lw1414/punch-replica/punch-replica/3D/SMD-4_L4.6-W6.5-H3.7-LS10.2-P2.54.step

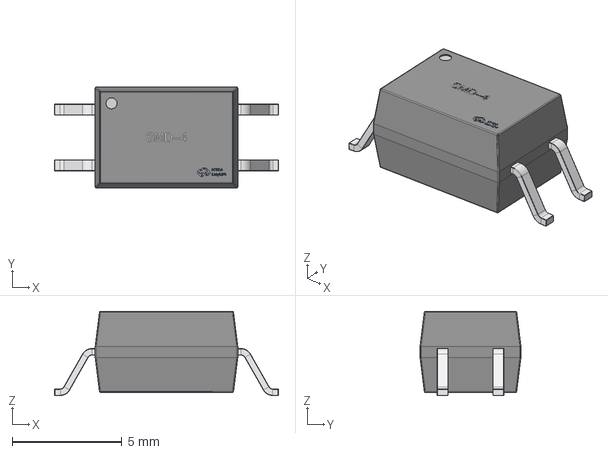
[picture p1: CAD file, 2026-02-18]
punch-replica/3D/SMD-4_L4.6-W6.5-H3.7-LS10.2-P2.54.step
10.2 x 4.60 x 3.85 mm
