lw1414/punch-replica/punch-replica/3D/SC-70-3_L2.0-W1.3-H1.0-P0.65.step

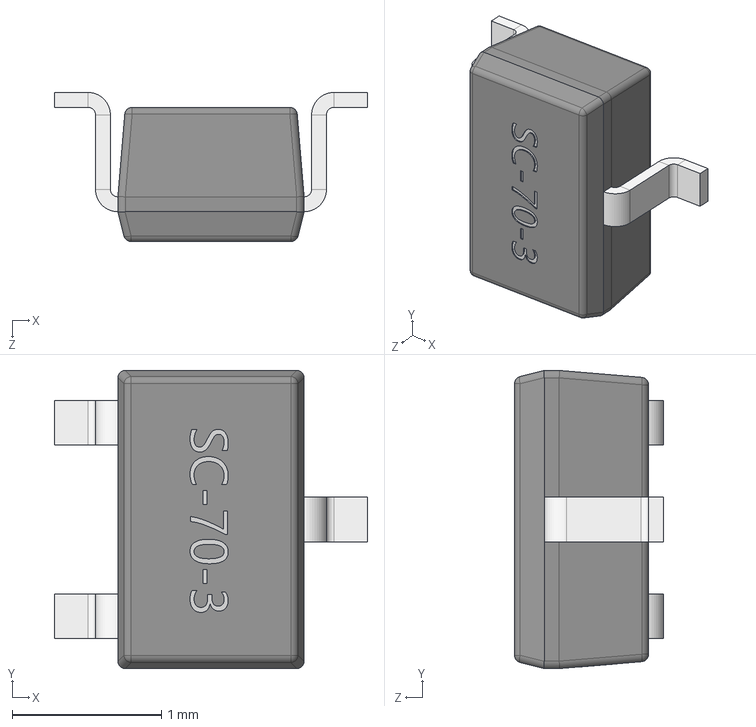
[picture p2: CAD file, 2026-02-18]
punch-replica/3D/SC-70-3_L2.0-W1.3-H1.0-P0.65.step
2.10 x 2.00 x 1.00 mm
