lw1414/punch-replica/punch-replica/3D/DFR0299.step

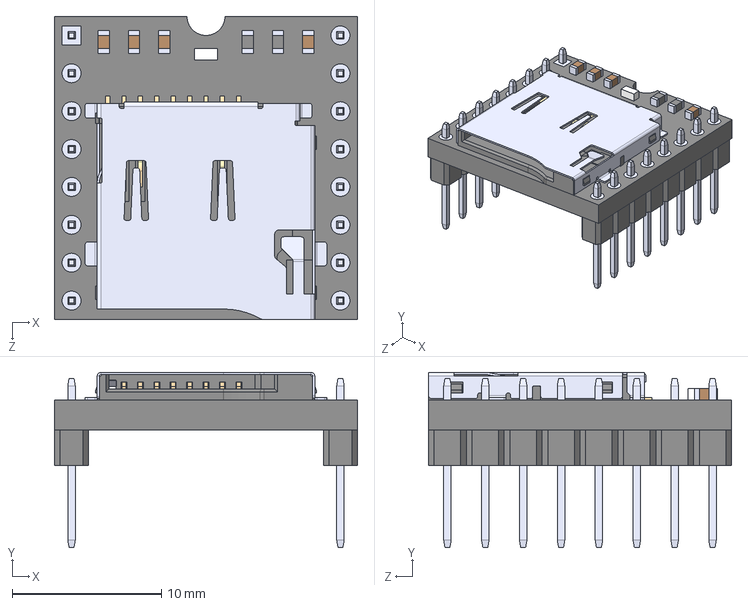
[picture p3: CAD file, 2026-02-18]
punch-replica/3D/DFR0299.step
20.3 x 11.8 x 20.3 mm
