lw1414/punch-replica/punch-replica/punch-replica.kicad_pcb

## KiCad design punch-replica/punch-replica.kicad_pcb (2026-03-03)

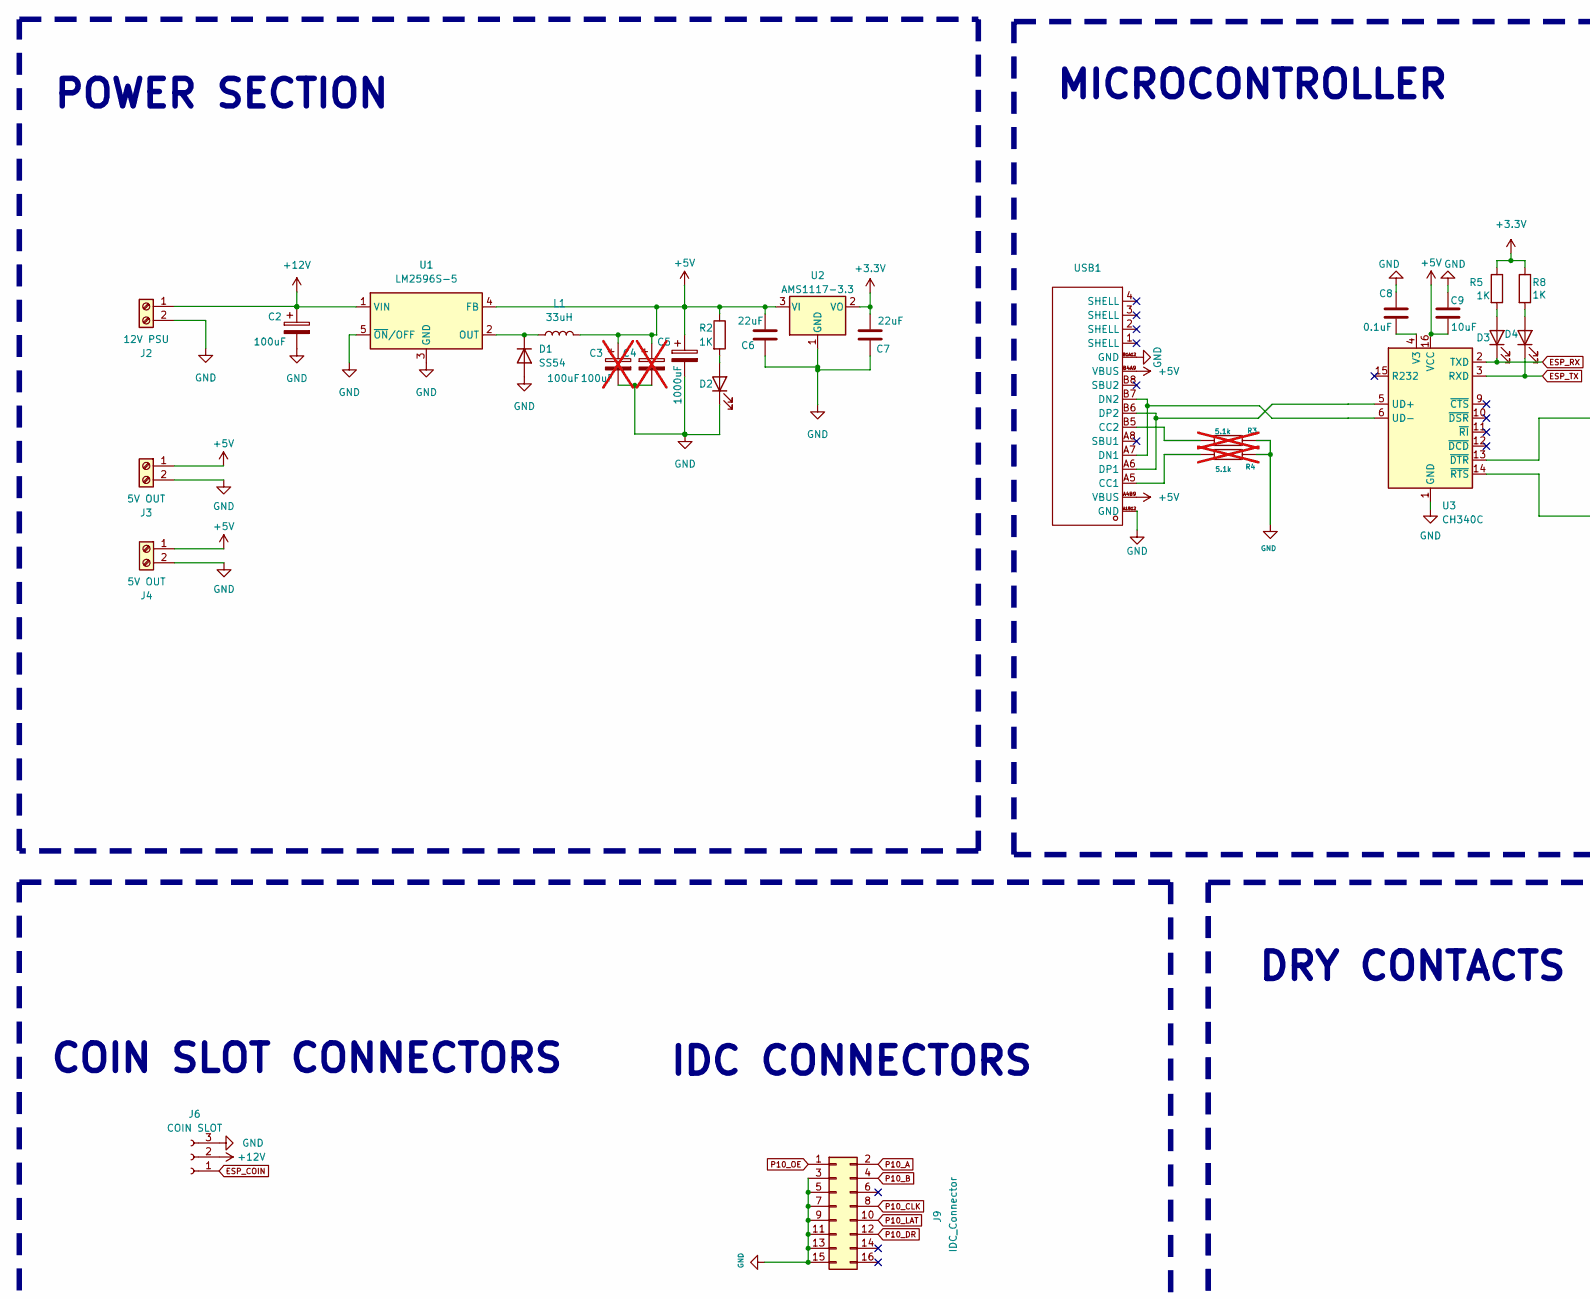
[picture p13: schematic punch-replica.kicad_sch, part in row 1, column 1]

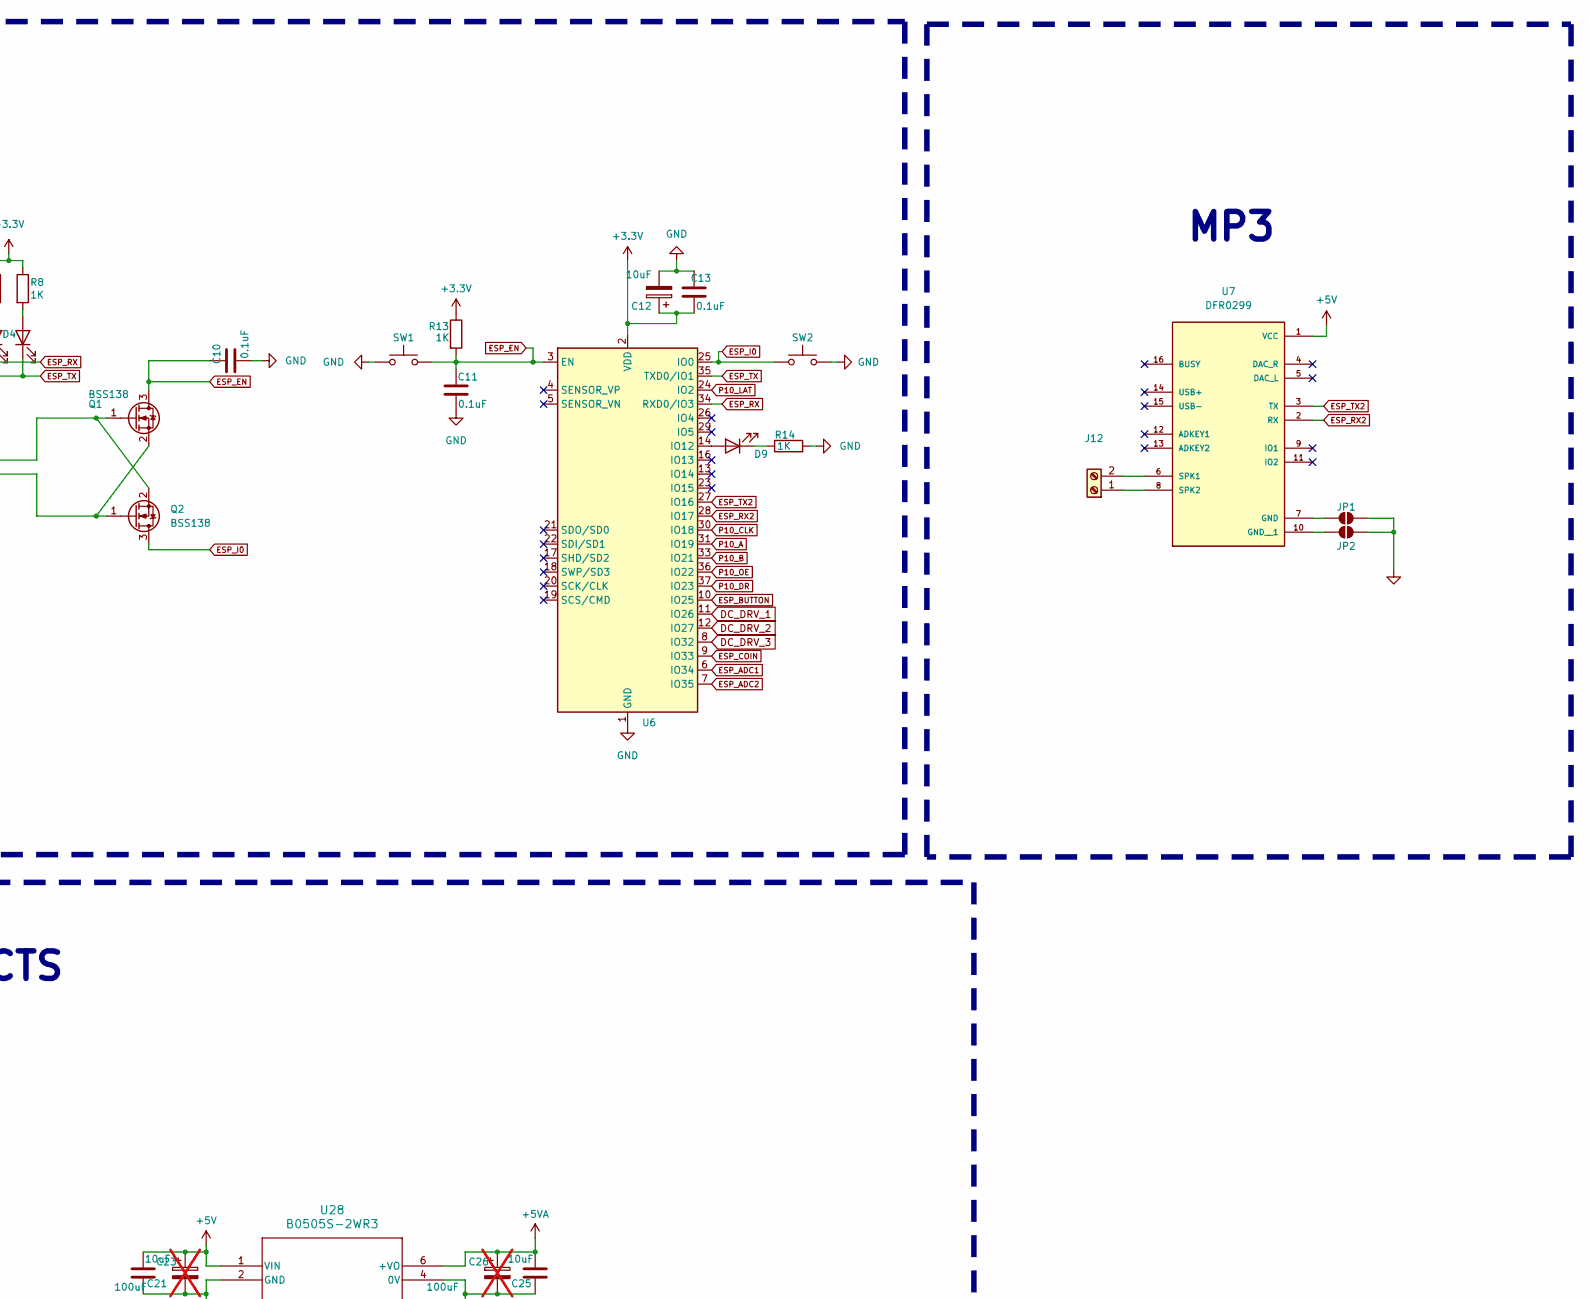
[picture p14: schematic punch-replica.kicad_sch, part in row 1, column 2]

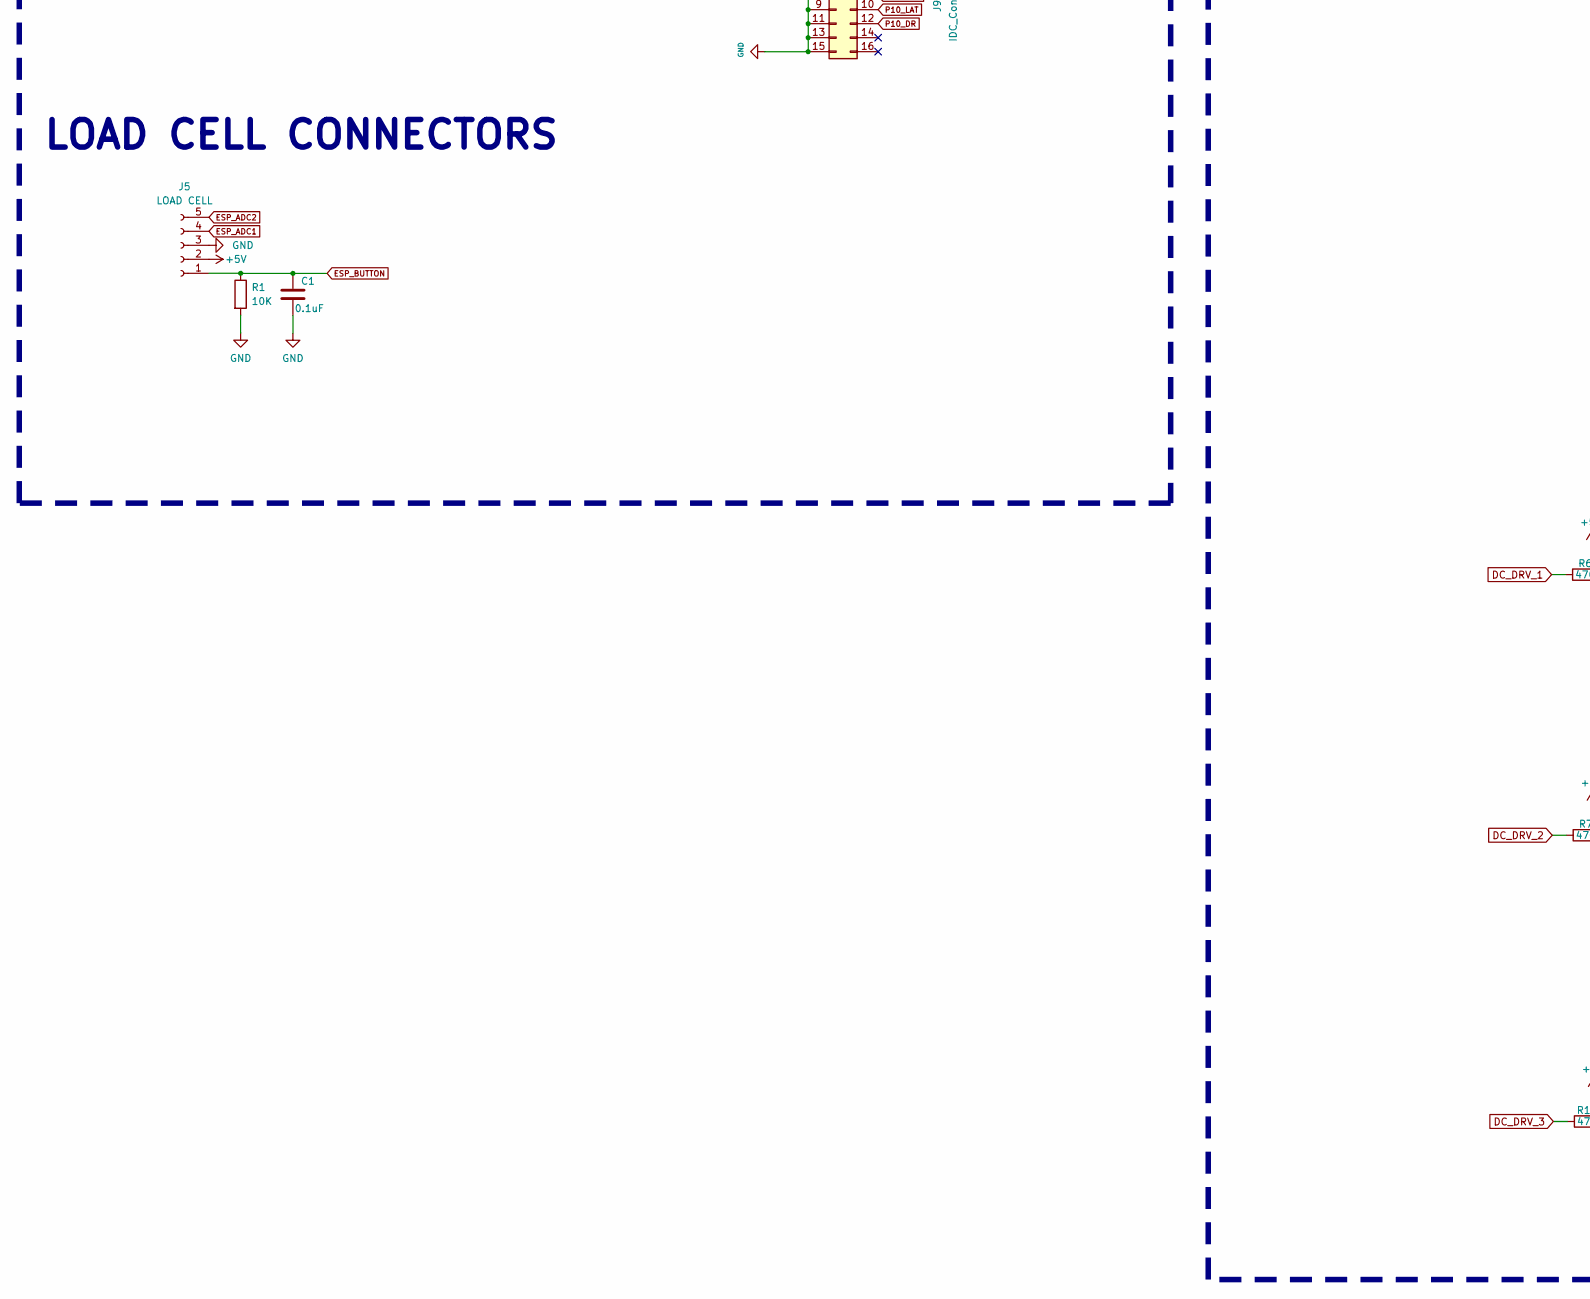
[picture p15: schematic punch-replica.kicad_sch, part in row 2, column 1]

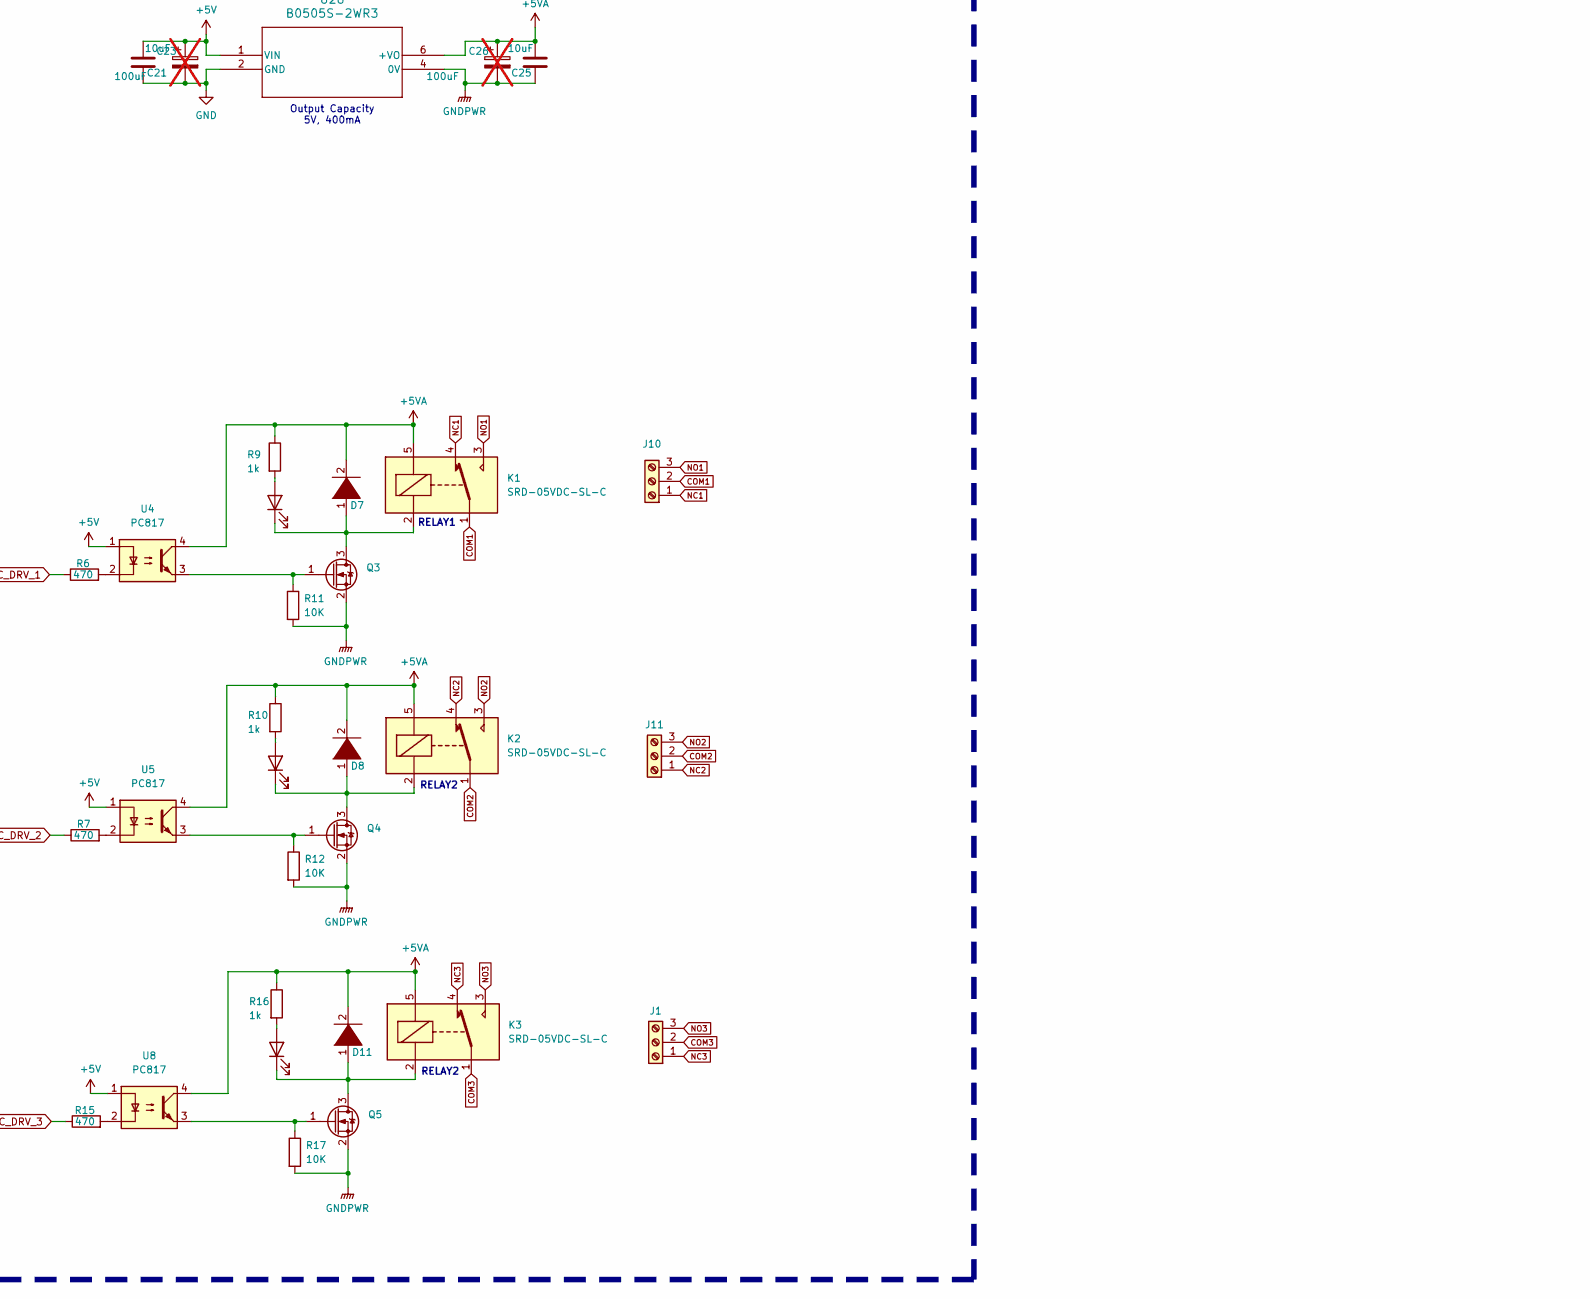
[picture p16: schematic punch-replica.kicad_sch, part in row 2, column 2]

Parts:
C1, C8, C10, C11, C13: 0.1uF; C_0805_2012Metric_Pad1.18x1.45mm_HandSolder; LCSC C49678
C2: 100uF; C_Elec_10x10.2; LCSC C28241
C3, C4, C23, C26: 100uF; C_1210_3225Metric_Pad1.33x2.70mm_HandSolder; LCSC C394395; not fitted
C5: 1000uF; C_Elec_10x10.2; LCSC C189257
C6, C7: 22uF; C_0603_1608Metric; LCSC C59461
C9, C12, C21, C25: 10uF; C_0805_2012Metric_Pad1.18x1.45mm_HandSolder; LCSC C15850
D1: SS54; D_SMA; LCSC C22452
D2, D3, D4, D5, D6, D9, D10: LED; LED_0805_2012Metric_Pad1.15x1.40mm_HandSolder; LCSC C2297
D7, D8, D11: 1N4001; D_SOD-123F; LCSC C2892326
J1, J10, J11: Screw_Terminal_01x03; TerminalBlock_Phoenix_MKDS-1,5-3_1x03_P5.00mm_Horizontal
J2: 12V PSU; TerminalBlock_MaiXu_MX126-5.0-02P_1x02_P5.00mm
J3, J4: 5V OUT; TerminalBlock_MaiXu_MX126-5.0-02P_1x02_P5.00mm
J5: LOAD CELL; TerminalBlock_Phoenix_MKDS-1,5-5-5.08_1x05_P5.08mm_Horizont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
J6: COIN SLOT; TerminalBlock_Phoenix_MKDS-1,5-3_1x03_P5.00mm_Horizontal
J9: IDC_Connector; IDC-TH_16P-P2.54_C3406
J12: Screw_Terminal_01x02; TerminalBlock_MaiXu_MX126-5.0-02P_1x02_P5.00mm
JP1, JP2: SolderJumper_2_Open; SolderJumper-2_P1.3mm_Open_RoundedPad1.0x1.5mm
K1, K2, K3: SRD-05VDC-SL-C; Relay_SPDT_SANYOU_SRD_Series_Form_C; LCSC C35449
L1: 33uH; 470; LCSC C475918
Q1, Q2: BSS138; SOT-23; LCSC C426569
Q3, Q4, Q5: Q_NMOS_Depletion_GSD; SOT-23-3; LCSC C75882
R1, R11, R12, R17: 10K; R_0603_1608Metric_Pad0.98x0.95mm_HandSolder; LCSC C25804
R2, R5, R8, R13, R14: 1K; R_0603_1608Metric_Pad0.98x0.95mm_HandSolder; LCSC C21190
R3, R4: 5.1k; R_0603_1608Metric_Pad0.98x0.95mm_HandSolder; LCSC C103079; not fitted
R6, R7, R15: 470; R_0603_1608Metric_Pad0.98x0.95mm_HandSolder; LCSC C25210
R9, R10, R16: 1k; R_0603_1608Metric_Pad0.98x0.95mm_HandSolder; LCSC C21190
SW1, SW2: SW_Push; SW_Tactile_SPST_NO_Straight_CK_PTS636Sx25SMTRLFS; LCSC C2689642
U1: LM2596S-5; TO-263-5_TabPin3; LCSC C347421
U2: AMS1117-3.3; SOT-223-3_TabPin2; LCSC C5199435
U3: CH340C; SOP-16_3.9x9.9mm_P1.27mm; LCSC C84681
U4, U5, U8: PC817; APC-817xx-SL_AMB; LCSC C66405
U6: ESP32-WROOM-32; ESP32-WROOM-32U; LCSC C529577
U7: DFR0299; MODULE_DFR0299
U28: B0505S-2WR3; B_S-2WR2_MNS; LCSC C5369473
USB1: USB-C-SMD_TYPE-C16PIN; Manufacturer Part TYPE-C16PIN; LCSC Part Name Type-C 母 卧贴

Connections:
+3.3V: C7.2, C12.1, C13.1, R5.1, R8.1, R13.1, U2.2 (VO), U6.2 (VDD)
+5V: C3.1, C4.1, C5.1, C6.2, C9.1, C21.2, C23.1, J3.1, J4.1, J5.2, L1.2, R2.1, U1.4 (FB), U2.3 (VI), U3.16 (VCC), U4.1, U5.1, U7.1 (VCC), U8.1, U28.1 (VIN), USB1.A4B9 (VBUS), USB1.B4A9 (VBUS)
+5VA: C25.2, C26.1, D7.2 (A), D8.2 (A), D11.2 (A), K1.5, K2.5, K3.5, R9.1, R10.1, R16.1, U4.4, U5.4, U8.4, U28.6 (+VO)
+12V: C2.1, J2.1, J6.2, U1.1 (VIN)
COM1: J10.2, K1.1
COM2: J11.2, K2.1
COM3: J1.2, K3.1
DC_DRV_1: R6.1, U6.11 (IO26)
DC_DRV_2: R7.1, U6.12 (IO27)
DC_DRV_3: R15.1, U6.8 (IO32)
ESP_ADC1: J5.4, U6.6 (IO34)
ESP_ADC2: J5.5, U6.7 (IO35)
ESP_BUTTON: C1.2, J5.1, R1.1, U6.10 (IO25)
ESP_COIN: J6.1, U6.9 (IO33)
ESP_EN: C10.2, C11.2, Q1.3 (D), R13.2, SW1.2, U6.3 (EN)
ESP_I0: Q2.3 (D), SW2.1, U6.25 (IO0)
ESP_RX: D3.1 (K), U3.2 (TXD), U6.34 (RXD0/IO3)
ESP_RX2: U6.28 (IO17), U7.2 (RX)
ESP_TX: D4.1 (K), U3.3 (RXD), U6.35 (TXD0/IO1)
ESP_TX2: U6.27 (IO16), U7.3 (TX)
GND: C1.1, C2.2, C3.2, C4.2, C5.2, C6.1, C7.1, C8.2, C9.2, C10.1, C11.1, C12.2, C13.2, C21.1, C23.2, D1.2 (A), D2.1 (K), J2.2, J3.2, J4.2, J5.3, J6.3, J9.3, J9.5, J9.7, J9.9, J9.11, J9.13, J9.15, JP1.2 (B), JP2.2 (B), R1.2, R3.2, R4.2, R14.2, SW1.1, SW2.2, U1.3 (GND), U1.5 (~ON/OFF), U2.1 (GND), U3.1 (GND), U6.1 (GND), U6.15 (GND), U6.38 (GND), U6.39 (GND), U28.2 (GND), USB1.A1B12 (GND), USB1.B1A12 (GND)
GNDPWR: C25.1, C26.2, Q3.2 (S), Q4.2 (S), Q5.2 (S), R11.2, R12.2, R17.2, U28.4 (0V)
NC1: J10.1, K1.4
NC2: J11.1, K2.4
NC3: J1.1, K3.4
NO1: J10.3, K1.3
NO2: J11.3, K2.3
NO3: J1.3, K3.3
unnamed: D1.1 (K), L1.1, U1.2 (OUT)
unnamed: D2.2 (A), R2.2
unnamed: D3.2 (A), R5.2
unnamed: D4.2 (A), R8.2
unnamed: D5.2 (A), R9.2
unnamed: D5.1 (K), D7.1 (K), K1.2, Q3.3 (D)
unnamed: D6.2 (A), R10.2
unnamed: D6.1 (K), D8.1 (K), K2.2, Q4.3 (D)
unnamed: D9.2 (A), U6.14 (IO12)
unnamed: D9.1 (K), R14.1
unnamed: D10.2 (A), R16.2
unnamed: D10.1 (K), D11.1 (K), K3.2, Q5.3 (D)
unnamed: J12.1, U7.8 (SPK2)
unnamed: J12.2, U7.6 (SPK1)
unnamed: JP1.1 (A), U7.7 (GND)
unnamed: JP2.1 (A), U7.10 (GND__1)
unnamed: Q1.1 (G), Q2.2 (S), U3.13 (~DTR)
unnamed: Q1.2 (S), Q2.1 (G), U3.14 (~RTS)
unnamed: Q3.1 (G), R11.1, U4.3
unnamed: Q4.1 (G), R12.1, U5.3
unnamed: Q5.1 (G), R17.1, U8.3
unnamed: R6.2, U4.2
unnamed: R7.2, U5.2
unnamed: R15.2, U8.2
unnamed: U3.5 (UD+), USB1.A6 (DP1), USB1.B6 (DP2)
unnamed: U3.6 (UD-), USB1.A7 (DN1), USB1.B7 (DN2)
unnamed: C8.1, U3.4 (V3)
unnamed: R4.1, USB1.A5 (CC1)
unnamed: R3.1, USB1.B5 (CC2)
P10_A: J9.2, U6.31 (IO19)
P10_B: J9.4, U6.33 (IO21)
P10_CLK: J9.8, U6.30 (IO18)
P10_DR: J9.12, U6.37 (IO23)
P10_LAT: J9.10, U6.24 (IO2)
P10_OE: J9.1, U6.36 (IO22)

Notes on the sheet:
Output Capacity 5V, 400mA
MICROCONTROLLER
MP3
DRY CONTACTS
RELAY2
RELAY1
POWER SECTION
LOAD CELL CONNECTORS
IDC CONNECTORS
COIN SLOT CONNECTORS

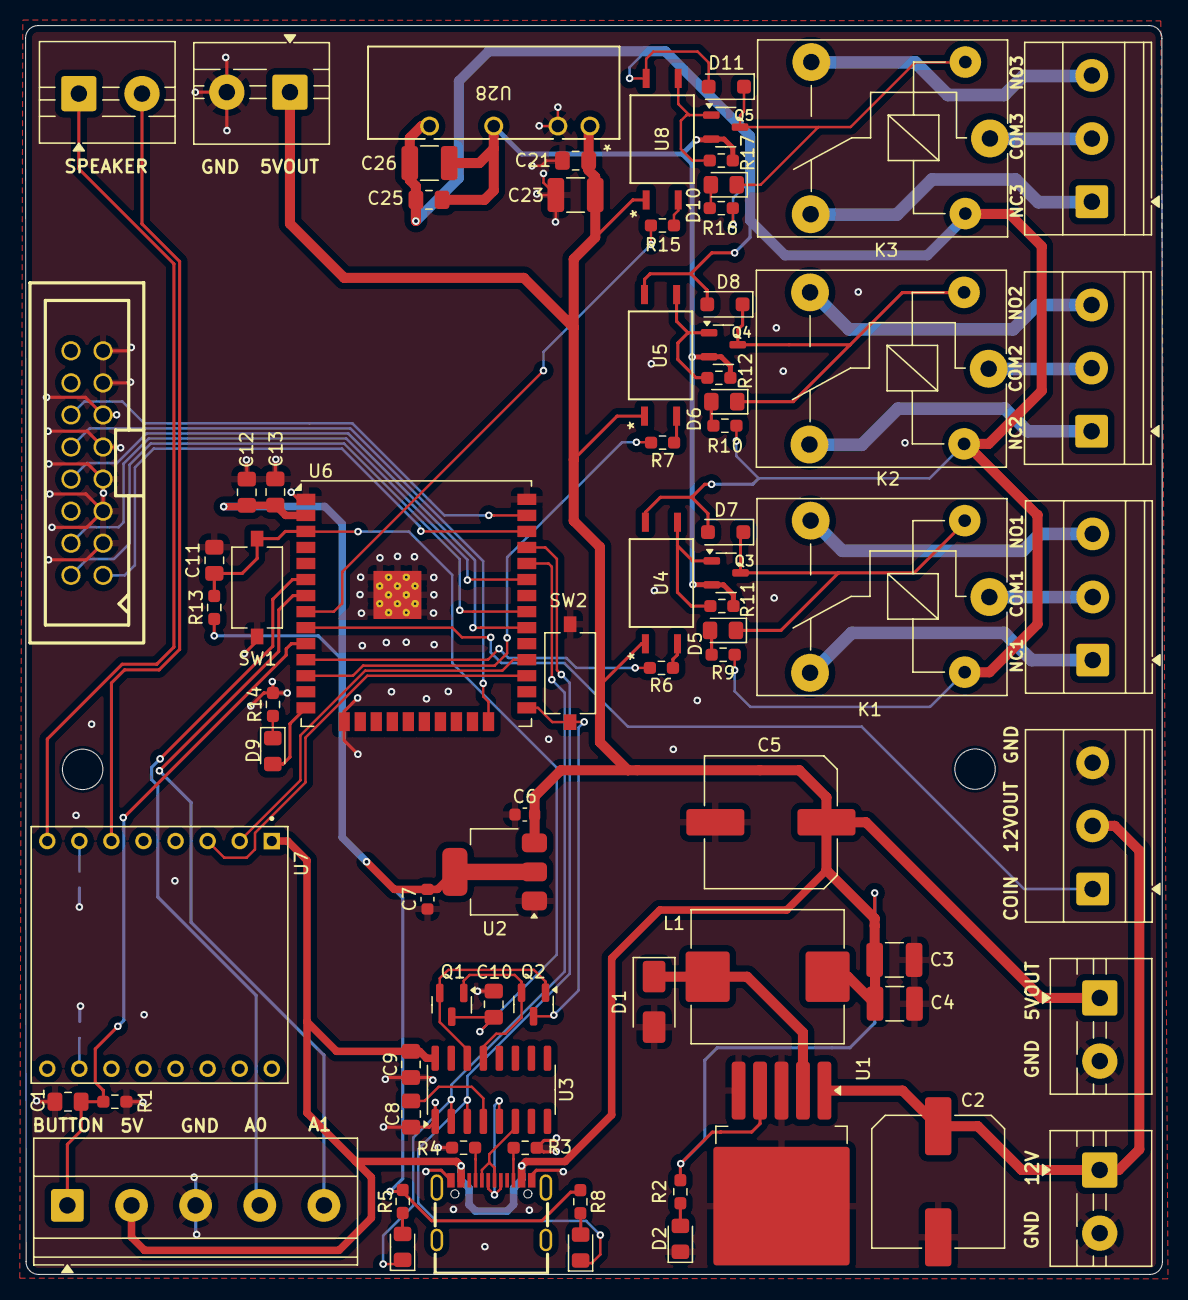
[picture p17: board punch-replica.kicad_pcb from above]

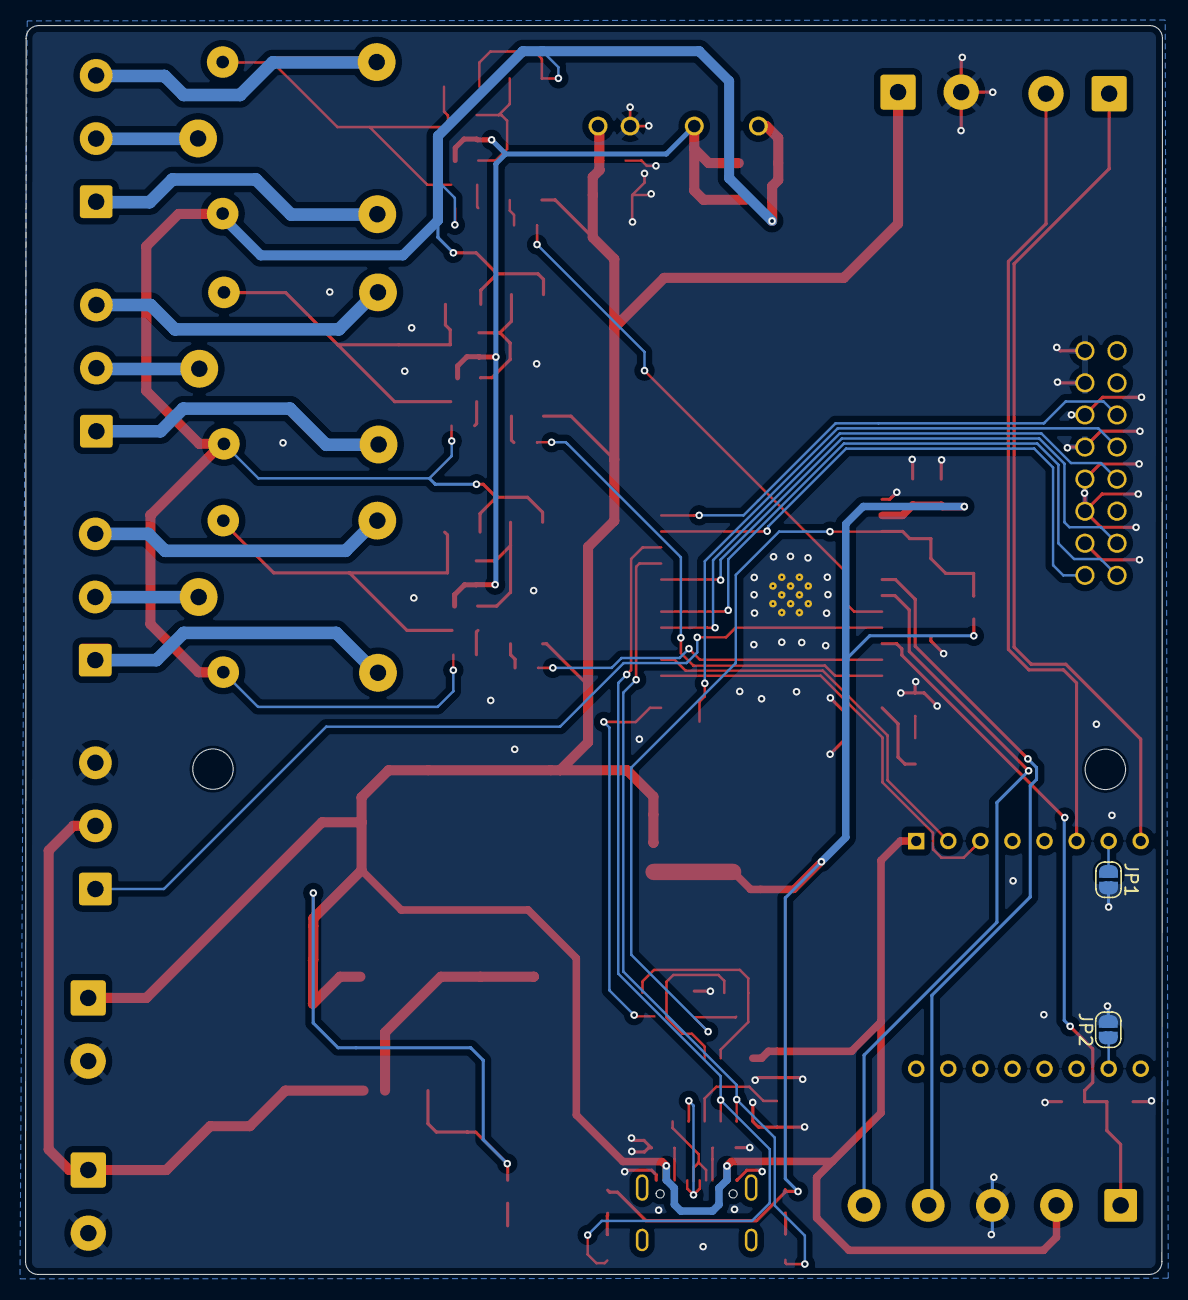
[picture p18: board punch-replica.kicad_pcb from below]

Board: 2 copper layers, 90.0 x 98.9 mm, 78 parts (2 on the bottom side), 63 nets.
