lw1414/punch-replica/(commit log)

2026-02-11 pcb parts placement
    [punch-replica.kicad_pcb, punch-replica.kicad_sch]
2026-03-03 - adjustment
    [punch-replica.kicad_pcb, punch-replica.kicad_sch]
2026-04-21 -
    -add punch code whole process
    -done idle state lcd
    -lacking fix on lcd
    -lacking scoring system
    [punch_machine_proc.ino]
